kez97460/PR_BLE_Wearable/README.md

# Projet de recherche - beacon BLE wearable

Projet de recherche de Lïam Lotte et Kézia Marcou - mineure E&E. 

Vous trouverez le rapport du projet en .pdf à ce [lien](project_report.pdf).
