kez97460/PR_BLE_Wearable/IN100_Configs/bma400_delattre_explanation.md

{
  "version": "3.8",
  "advSet": [
    {
      "id": 0,
      "bdAddr": "060504030201",
      "addrType": "public",
      "addrKey": 0,
      "addrGenInterval": 90,
      "interval": 1000,
      "authEn": 0,
      "authKey": 0,
      "authSaltType": 2,
      "authSaltValue": 0,
      "authEaxCountType": 0,
      "authEaxCountValue": 0,
      "ui_format": "custom",
      "uid2tlm_ratio": 0.0,
      "eddystoneTxPower": 0,
      "chCtrl": 0,
      "advModeTrigEn": 0,
      "is1MPhy": 1,
      "phyRate": "1M",
      "isStandardBle": 1,
      "cte": 0,
      "cteLen": 0,
      "randomDlyType": 0,
      "payloadVer": 3,
      "payload": [
        {
          "len": 12,
          "type": 9,
          "data": "424d413430305f44617461"
        },
        {
          "len": 10,
          "type": 255,
          "data": "0505<VCC 1byte 0 0><I2C1R0 6byte 0 0>"
        }
      ]
    }
  ],
  "txSetting": {
    "txPower": 0,
    "sleepAftTx": 1,
    "uartSingleWire": 0,
    "uartPinSel": 0,
    "xoCap": 8,
    "xoStableTime": 36,
    "xoGm": 16,
    "ch0": 37,
    "ch1": 38,
    "ch2": 39,
    "key0": "000102030405060708090a0b0c0d0e0f"
  },
  "gpio": [
    {"id": 0, "digital": "default", "pu-pd": 1, "wakeup": "disable", "advTrig": "disable", "latch": 0, "maskb": 0},
    {"id": 1, "digital": "default", "pu-pd": 1, "wakeup": "disable", "advTrig": "disable", "latch": 0, "maskb": 0},
    {"id": 2, "digital": "default", "pu-pd": 1, "wakeup": "disable", "advTrig": "disable", "latch": 0, "maskb": 0},
    {"id": 3, "digital": "default", "pu-pd": 1, "wakeup": "disable", "advTrig": "disable", "latch": 0, "maskb": 0},
    {"id": 4, "digital": "default", "pu-pd": 1, "wakeup": "disable", "advTrig": "disable", "latch": 0, "maskb": 0},
    {"id": 5, "digital": "default", "pu-pd": 1, "wakeup": "disable", "advTrig": "disable", "latch": 0, "maskb": 0},
    {"id": 6, "digital": "default", "pu-pd": 1, "wakeup": "disable", "advTrig": "disable", "latch": 0, "maskb": 0},
    {"id": 7, "digital": "default", "pu-pd": 1, "wakeup": "disable", "advTrig": "disable", "latch": 0, "maskb": 0}
  ],
  "vccUnit": 0.03125,
  "tempUnit": 0.01,
  "adc": [
    {"ch": 0, "enable": 0},
    {"ch": 1, "enable": 0},
    {"ch": 2, "enable": 0},
    {"ch": 3, "enable": 0}
  ],
  "calibration": {},
  "i2c": {
    "sw0PwrCtl": 1,
    "coldBootEn": 1,
    "warmBootEn": 1,
    "sclPin": 2,
    "sdaPin": 3,
    "addrBit": 7,
    "speed": 400,
    "slvAddr": 20,
    "memStoreLen": 6,
    "memStoreOffset": 0,
    "cmd": [
      "i2c wait: 3 1 8", // wait
      "i2c tx: 3 19", // Register : ACC_CONFIG1 - Set the accelerometer config
      "i2c tx: 3 2", // Value : Set the normal power mode
      "i2c null:",
      "i2c wait: 3 1 4e", // us delay - 336us
      "i2c tx: 3 4", // Trigger accelerometer x value emissions
      "i2c null:",
      "i2c rx: 3", // Receive accelerometer x value LSB
      "i2c rx: 3", // Receive accelerometer x value MSB
      "i2c null:",
      "i2c tx: 3 6", // Trigger accelerometer y value emissions
      "i2c null:",
      "i2c rx: 3", // Receive accelerometer y value LSB
      "i2c rx: 3", // Receive accelerometer y value MSB
      "i2c null:",
      "i2c tx: 3 8", // Trigger accelerometer z value emissions
      "i2c null:",
      "i2c rx: 3", // Receive accelerometer z value LSB
      "i2c rx: 3", // Receive accelerometer z value MSB
      "i2c null:"
    ]
  },
  "i2c2": {"coldBootEn": 0, "warmBootEn": 0},
  "i2c3": {"coldBootEn": 0, "warmBootEn": 0},
  "pulse": {"enable": 0},
  "qdec": {
    "enable": 0,
    "runGpioEdgeDetect": 0,
    "clearCount": 0,
    "endCode": 15,
    "twoStep": 0,
    "interval": 999,
    "timeout": 1999,
    "gpio": [],
    "code": []
  },
  "wdt": {
    "timerWraparound": 0,
    "enable": 0,
    "wakeupChip": 0,
    "initValue": 30
  },
  "edgeCount": {"enable": 0},
  "regSetting": [
    "write: 0 1 3 3480 2010000",
    "write: 0 1 3 3484 3030002",
    "write: 0 1 1 34c8 102",
    "write: 0 1 3 3494 10020018",
    "write: 3 1 0 1084 0",
    "write: 3 1 0 11C8 0",
    "write: 3 1 0 1c44 c6",
    "write: 3 1 0 1ad0 58",
    "write: 3 1 1 1d04 731",
    "write: 0 1 0 3240 42",
    "write: 0 1 0 3500 03",
    "write: 0 1 3 32e8 ffffffff"
  ],
  "regSettingCust": [],
  "settingPolice": 0
}

After the trigger of the register in read mode, it reads the registers one after one.
0x06 -> 0x07 -> 0x08 etc
