kez97460/PR_BLE_Wearable/Electronic/PCB_rigide_test/layout.png

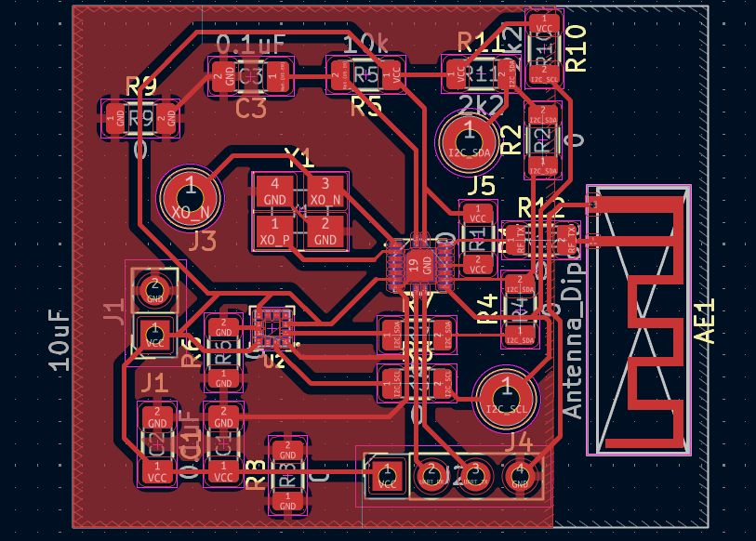
Electronic/PCB_rigide_test/layout.png
