kez97460/PR_BLE_Wearable/Electronic/PCB_rigide/PCB_rigide.pdf

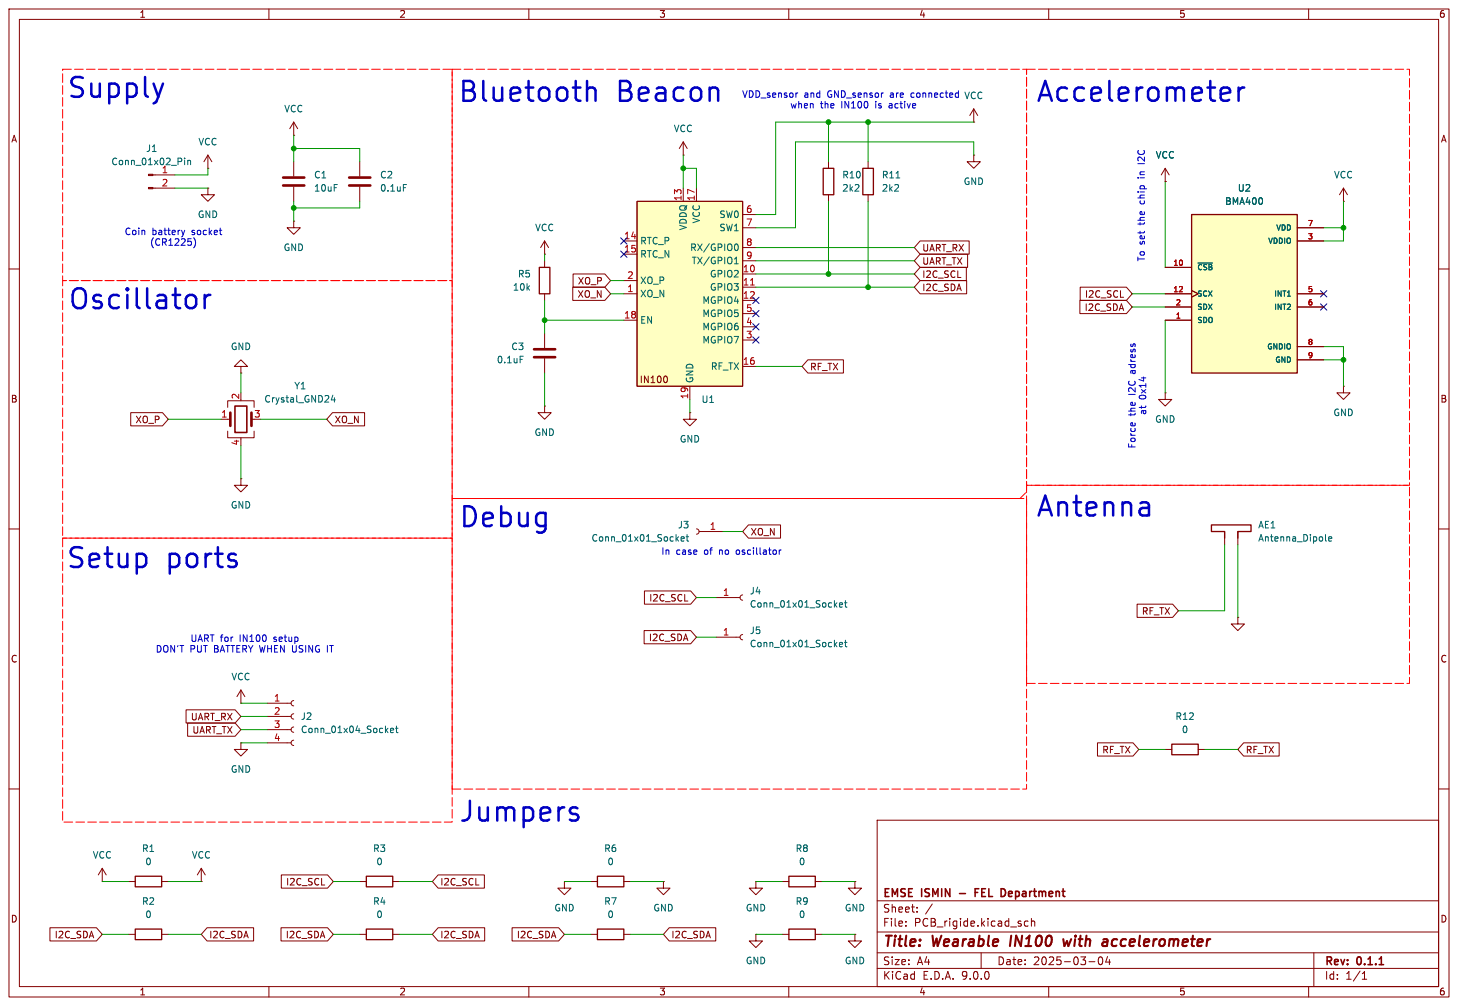
[picture p22: page 1]

In case of no oscillator Supply
VDD_sensor and GND_sensor are connected when the IN100 is active Setup ports

UART for IN100 setup DON'T PUT BATTERY WHEN USING IT Oscillator
