kez97460/PR_BLE_Wearable/Electronic/PCB_rigide/PCB_rigide_layout.pdf

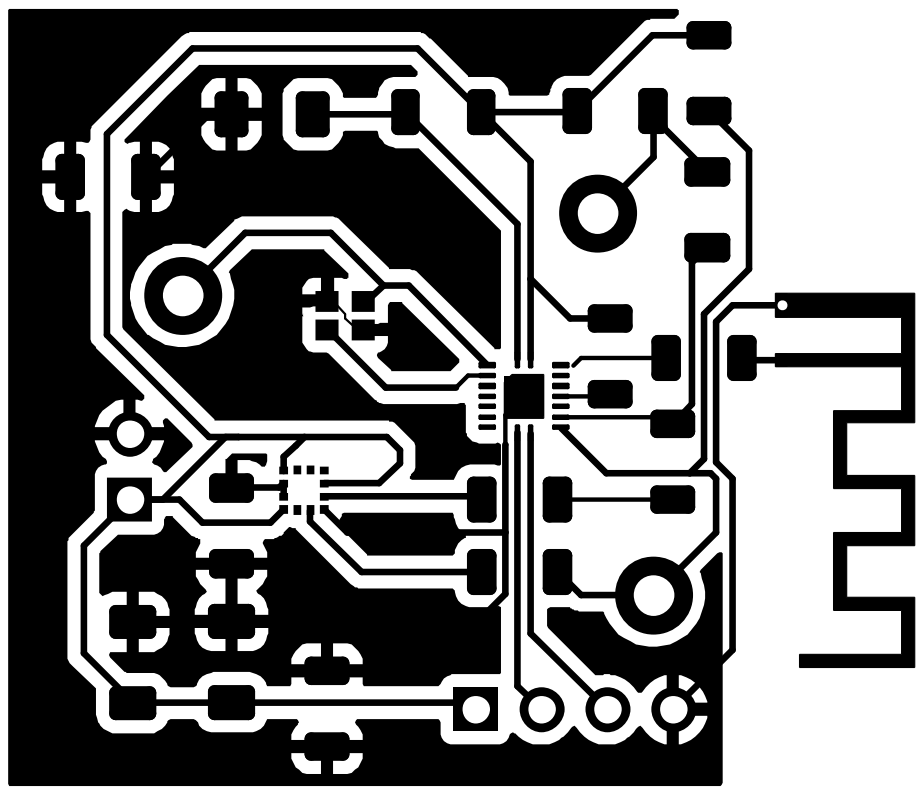
[picture p23: page 1]
