kez97460/PR_BLE_Wearable/Electronic/PCB_rigide/PCB_rigide.kicad_pcb

## KiCad design Electronic/PCB_rigide/PCB_rigide.kicad_pcb (2025-03-25)

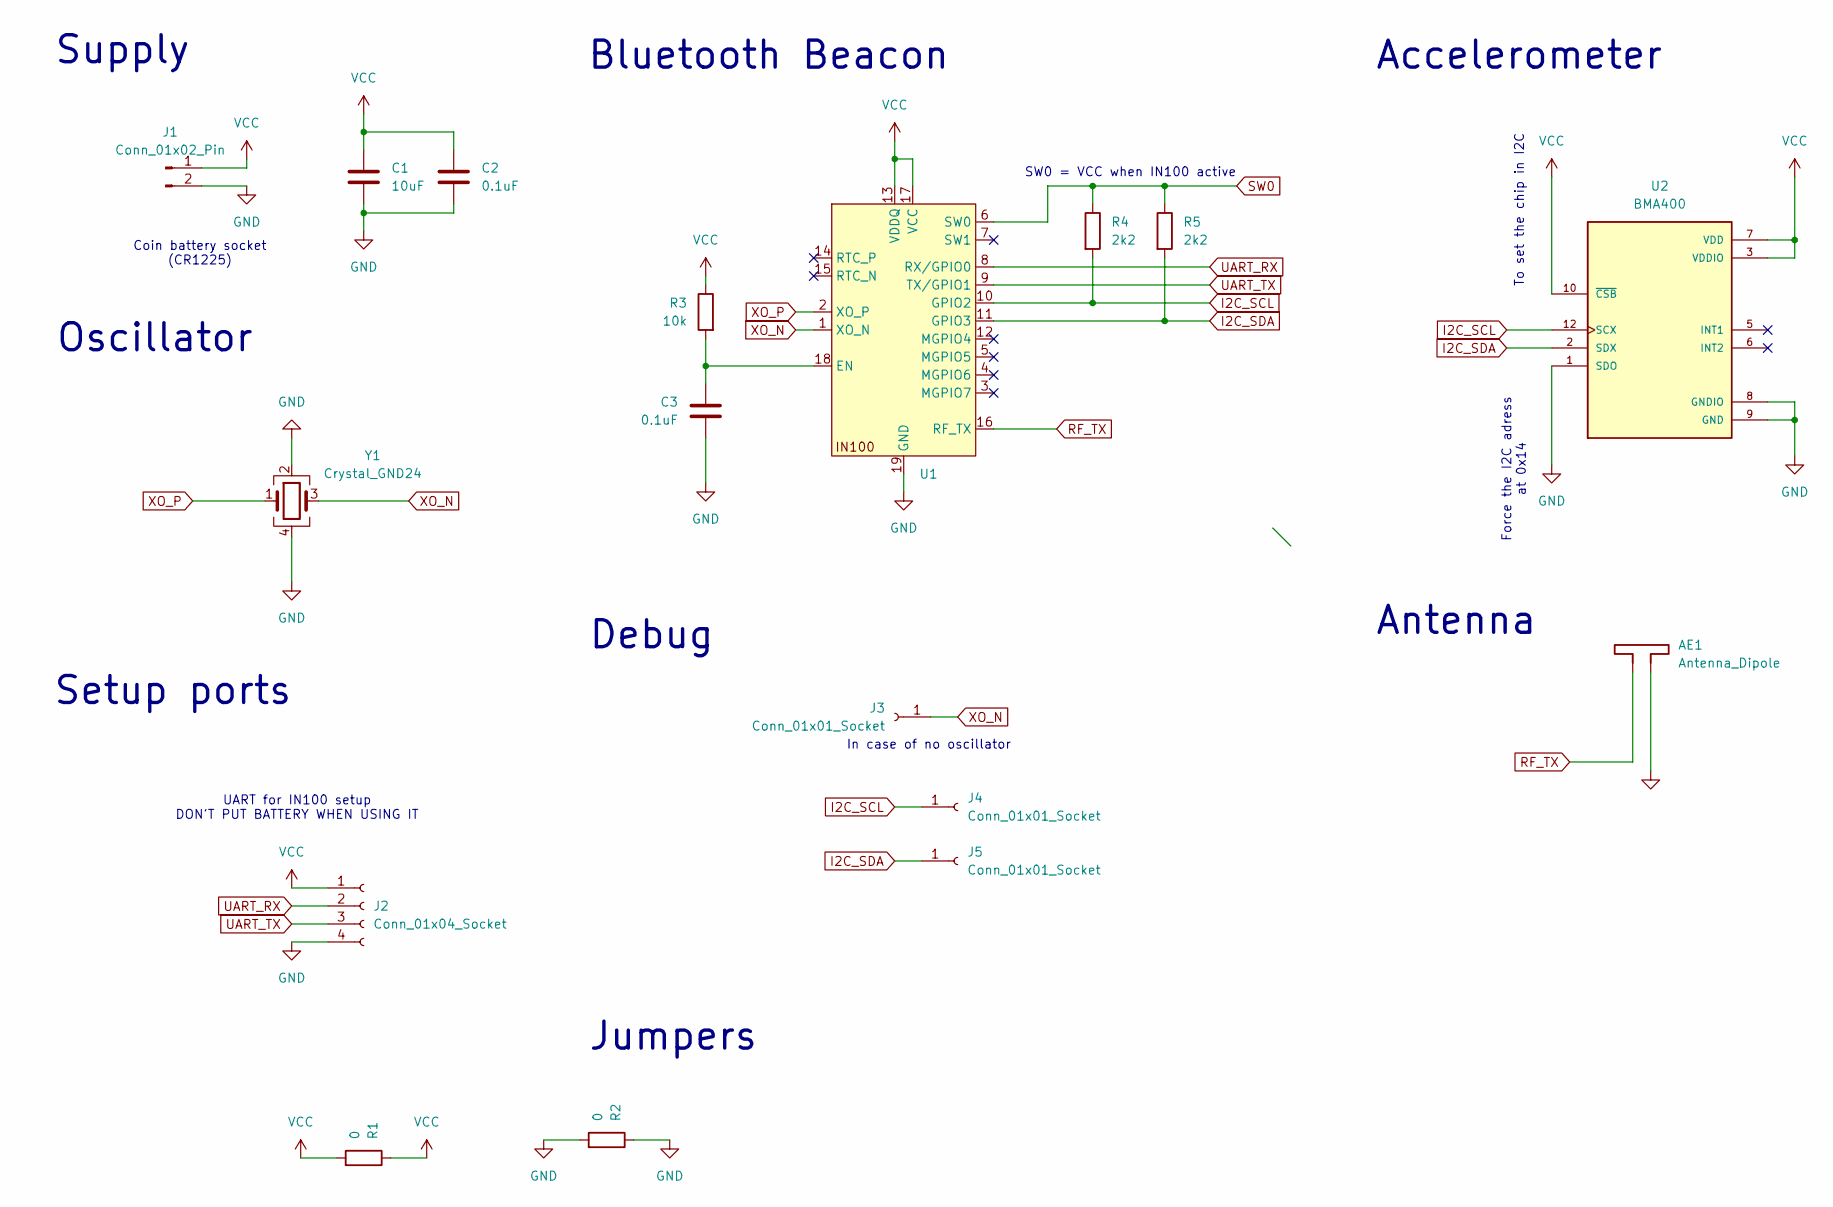
[picture p26: schematic PCB_rigide.kicad_sch, Wearable IN100 with accelerometer]

Parts:
AE1: Antenna_Dipole; Texas_SWRA117D_2.4GHz_Left
C1: 10uF; C_1206_3216Metric_Pad1.33x1.80mm_HandSolder
C2, C3: 0.1uF; C_1206_3216Metric_Pad1.33x1.80mm_HandSolder
J1: Conn_01x02_Pin; PinSocket_1x02_P2.54mm_Vertical
J2: Conn_01x04_Socket; PinSocket_1x04_P2.54mm_Vertical
J3, J4, J5: Conn_01x01_Socket; TestPoint_Loop_D2.54mm_Drill1.5mm_Beaded
R1, R2: 0; R_1206_3216Metric
R3: 10k; R_1206_3216Metric
R4, R5: 2k2; R_1206_3216Metric
U1: QFN19P40_300X300X80L35X20T170X150N
U2: BMA400; XDCR_BMA400; DigiKey_Part_Number 828-1081-2-ND
Y1: Crystal_GND24; Crystal_SMD_2016-4Pin_2.0x1.6mm

Connections:
GND: AE1.2, C1.2, C2.2, C3.2, J1.2, J2.4, R2.1, R2.2, U1.19 (GND), U2.1 (SDO), U2.8 (GNDIO), U2.9 (GND), Y1.2, Y1.4
I2C_SCL: J4.1, R4.2, U1.10 (GPIO2), U2.12 (SCX)
I2C_SDA: J5.1, R5.2, U1.11 (GPIO3), U2.2 (SDX)
unnamed: C3.1, R3.2, U1.18 (EN)
RF_TX: AE1.1, U1.16 (RF_TX)
SW0: R4.1, R5.1, U1.6 (SW0)
UART_RX: J2.2, U1.8 (RX/GPIO0)
UART_TX: J2.3, U1.9 (TX/GPIO1)
VCC: C1.1, C2.1, J1.1, J2.1, R1.1, R1.2, R3.1, U1.13 (VDDQ), U1.17 (VCC), U2.3 (VDDIO), U2.7 (VDD), U2.10 (~CSB)
XO_N: J3.1, U1.1 (XO_N), Y1.3
XO_P: U1.2 (XO_P), Y1.1

Notes on the sheet:
Accelerometer
In case of no oscillator
Debug
Antenna
Supply
Coin battery socket (CR1225)
UART for IN100 setup DON'T PUT BATTERY WHEN USING IT
Setup ports
Oscillator
Jumpers
To set the chip in I2C
Bluetooth Beacon
SW0 = VCC when IN100 active
Force the I2C adress at 0x14

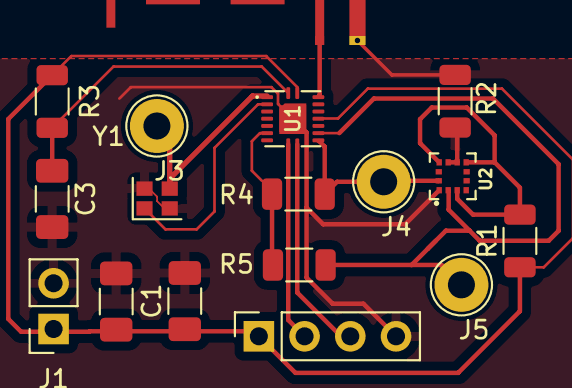
[picture p27: board Electronic/PCB_rigide/PCB_rigide.kicad_pcb from above]

Board: 2 copper layers, 17 parts (0 on the bottom side), 11 nets.
