kez97460/PR_BLE_Wearable/(commit log)

2025-03-05 python recup Vcc OK
    [bma400_delattre.cfg]
2025-03-06 appli web affichage Vcc
    [ble_data.csv, spc_data.csv]
2025-03-07 save before i break smth
    [ble_data.csv]
2025-03-07 retiré code inutile
    [ble_data.csv]
2025-03-10 init elec
    [PCB_rigide-B_Cu.gbr, PCB_rigide-B_Mask.gbr, PCB_rigide-B_Paste.gbr, PCB_rigide-B_Silkscreen.gbr, PCB_rigide-Edge_Cuts.gbr, PCB_rigide-F_Cu.gbr, PCB_rigide-F_Mask.gbr, PCB_rigide-F_Paste.gbr]
2025-03-25 update electronic
    [PCB_rigide-B_Cu.gbr, PCB_rigide-B_Mask.gbr, PCB_rigide-B_Paste.gbr, PCB_rigide-B_Silkscreen.gbr, PCB_rigide-Edge_Cuts.gbr, PCB_rigide-F_Cu.gbr, PCB_rigide-F_Mask.gbr, PCB_rigide-F_Paste.gbr]
2025-03-25 Arduino simu IN100 OK
    [bma400_delattre.cfg]
2025-03-25 add low power mode
